Gaabe/autonomouscarparking/README.md

# Autonomous Car Parking
Hardware and Software project on autonomous car parking

Developed in Czech Technical University in Prague, Department of Measurement by Gabriel Almeida
