Gaabe/autonomouscarparking/Auto Parking Car schematics final.png

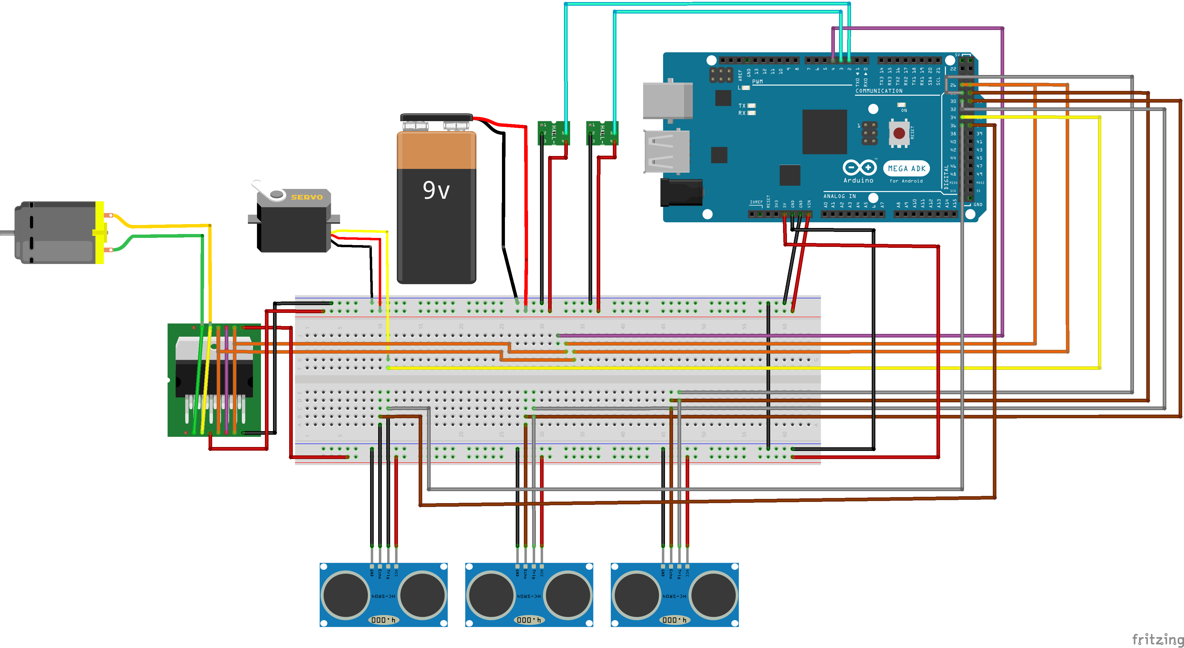
Auto Parking Car schematics final.png
