Gaabe/autonomouscarparking/(list of files, drawings)

Other design files:
Auto Parking Car schematics.fzz
